Tail-BackShape/RTR24Lien-AvioSys/Board/RJ45hub/production/bom.csv

Designator | Footprint | Quantity | Value | LCSC Part #
_4, _3, _2, |  | 4
J1, J2, J3, J4, J5, J6 | 7810-8P8C | 6 | RJ45
