Tail-BackShape/RTR24Lien-AvioSys/mount/mainIMU.stp

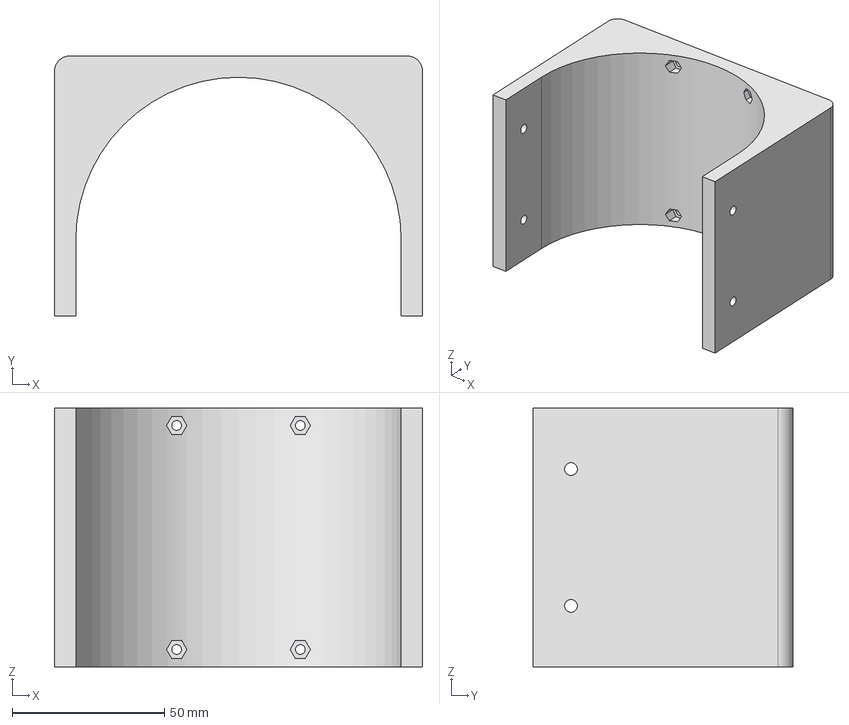
[picture p1: CAD file, 2024-07-04]
mount/mainIMU.stp
121.0 x 85.5 x 85.0 mm
