Tail-BackShape/RTR24Lien-AvioSys/(list of files, cad)

Other CAD files:
mount/OldVersions/airdatasensor.0001.ipt
mount/OldVersions/mainIMU.0003.ipt
mount/airdatasensor.ipt
mount/mainIMU.ipt
mount/mainIMU.stl
