Tail-BackShape/RTR24Lien-AvioSys/Board/AirDataCenter/AirDataCenter.pdf

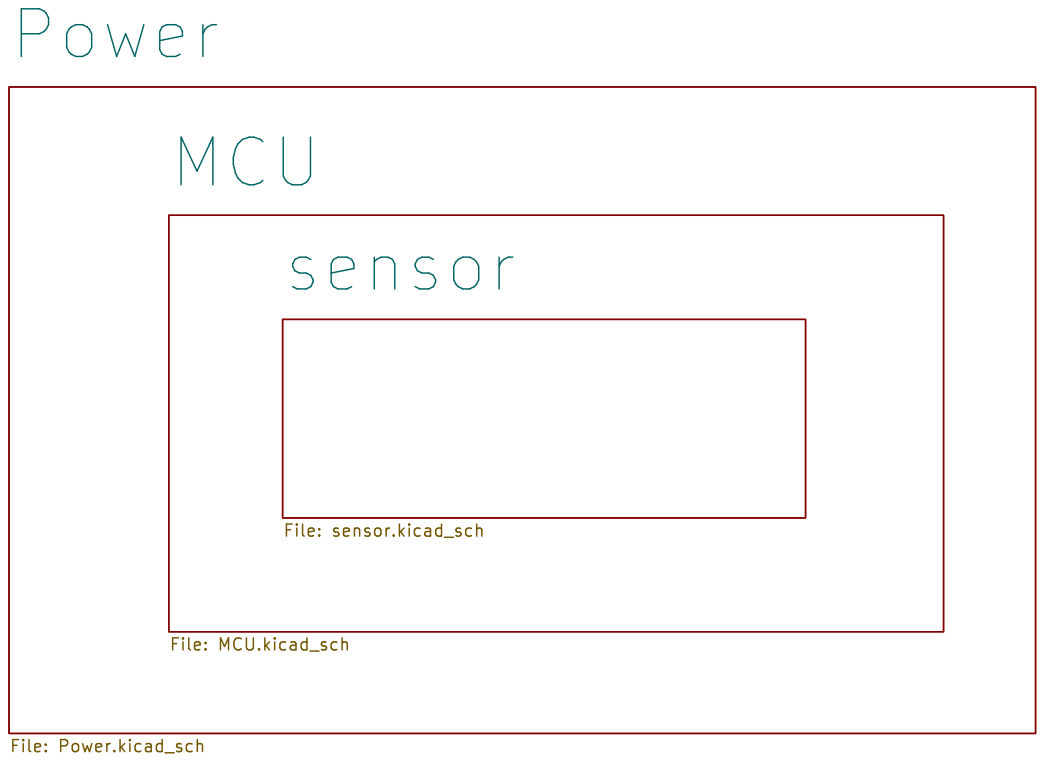
[picture p2: page 1]

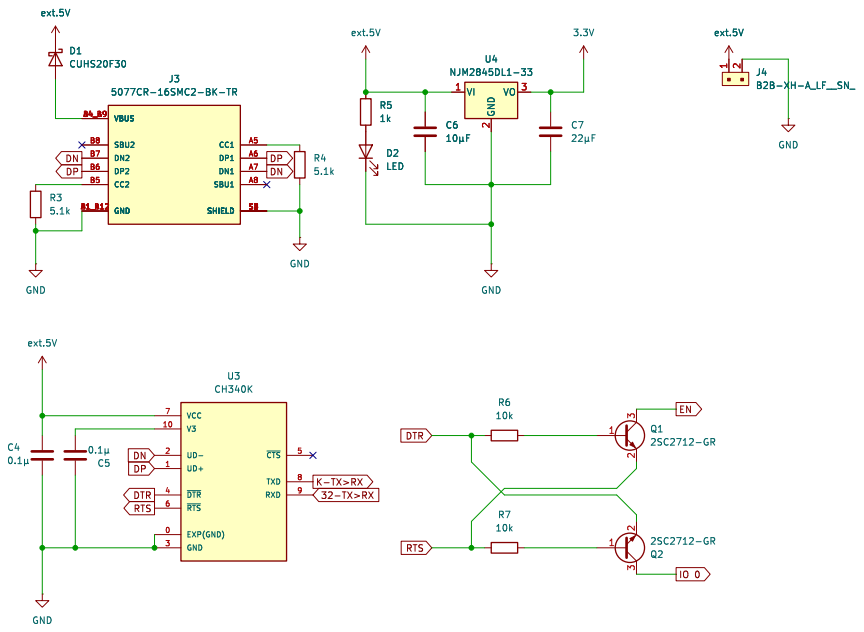
[picture p3: page 2]

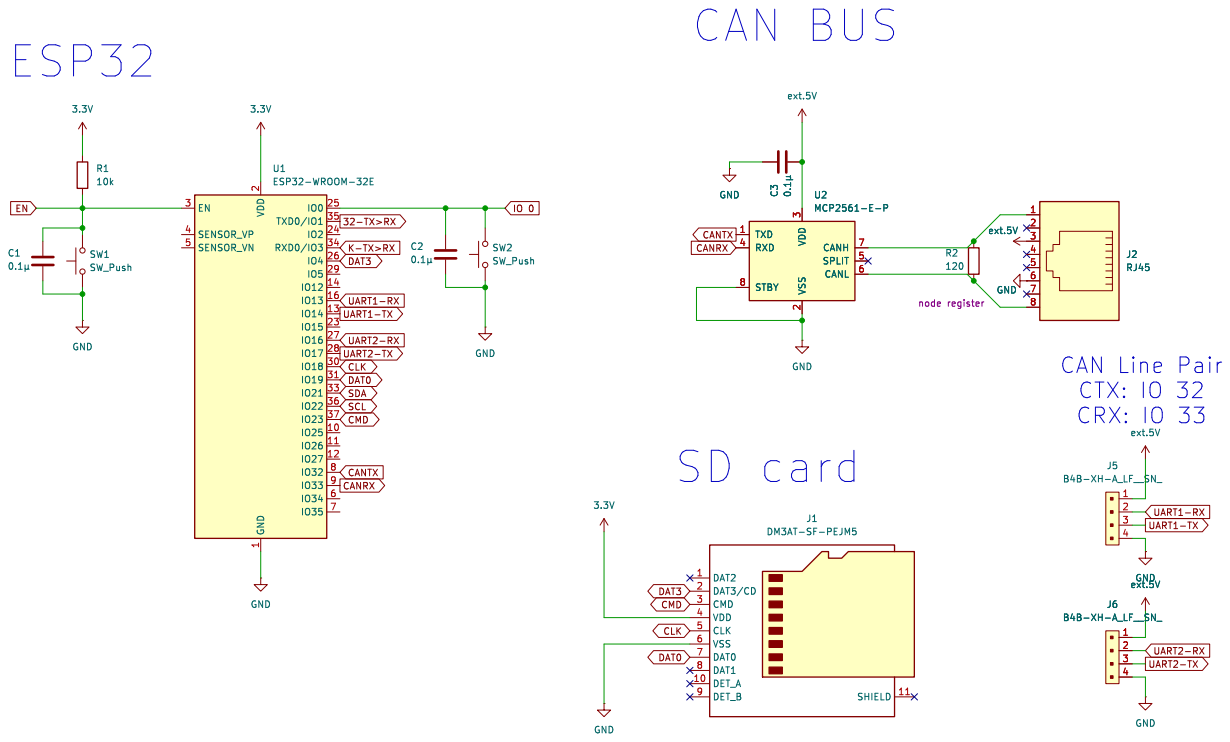
[picture p4: page 3]

node register 3.3V GND GND

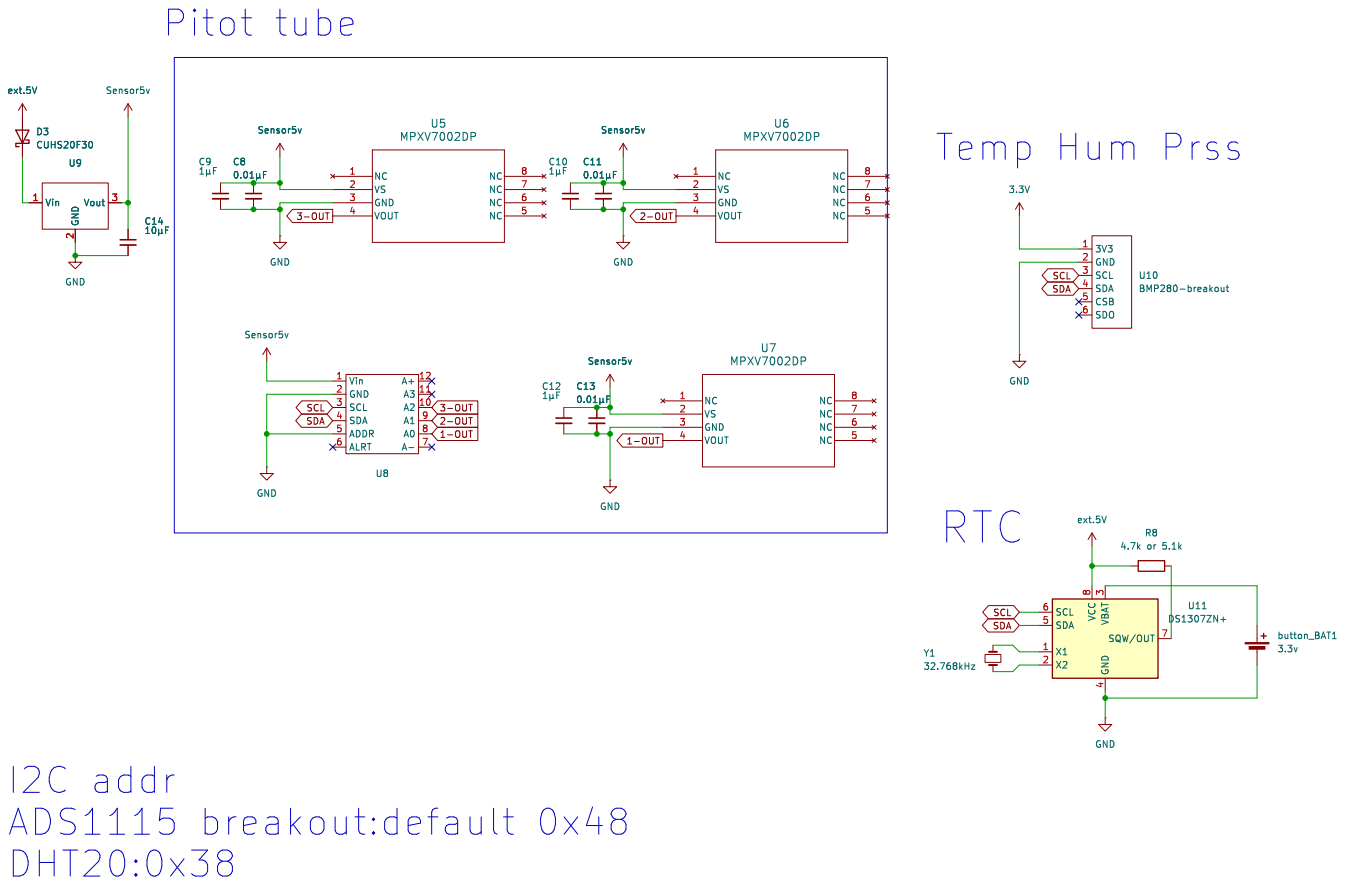
[picture p5: page 4]

8 U11 DS1307ZN+ Vin 1 A2 10 A3 11 A+ 12 GND 2 SCL 3 SDA 4 ADDR 5 ALRT 6 A- 7 A0 8 A1 9 U8 C12

4 SDA 5 SCL 6 SQW/OUT 7 VCC
