Tail-BackShape/RTR24Lien-AvioSys/Board/Main-IMU/Main-IMU.pdf

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

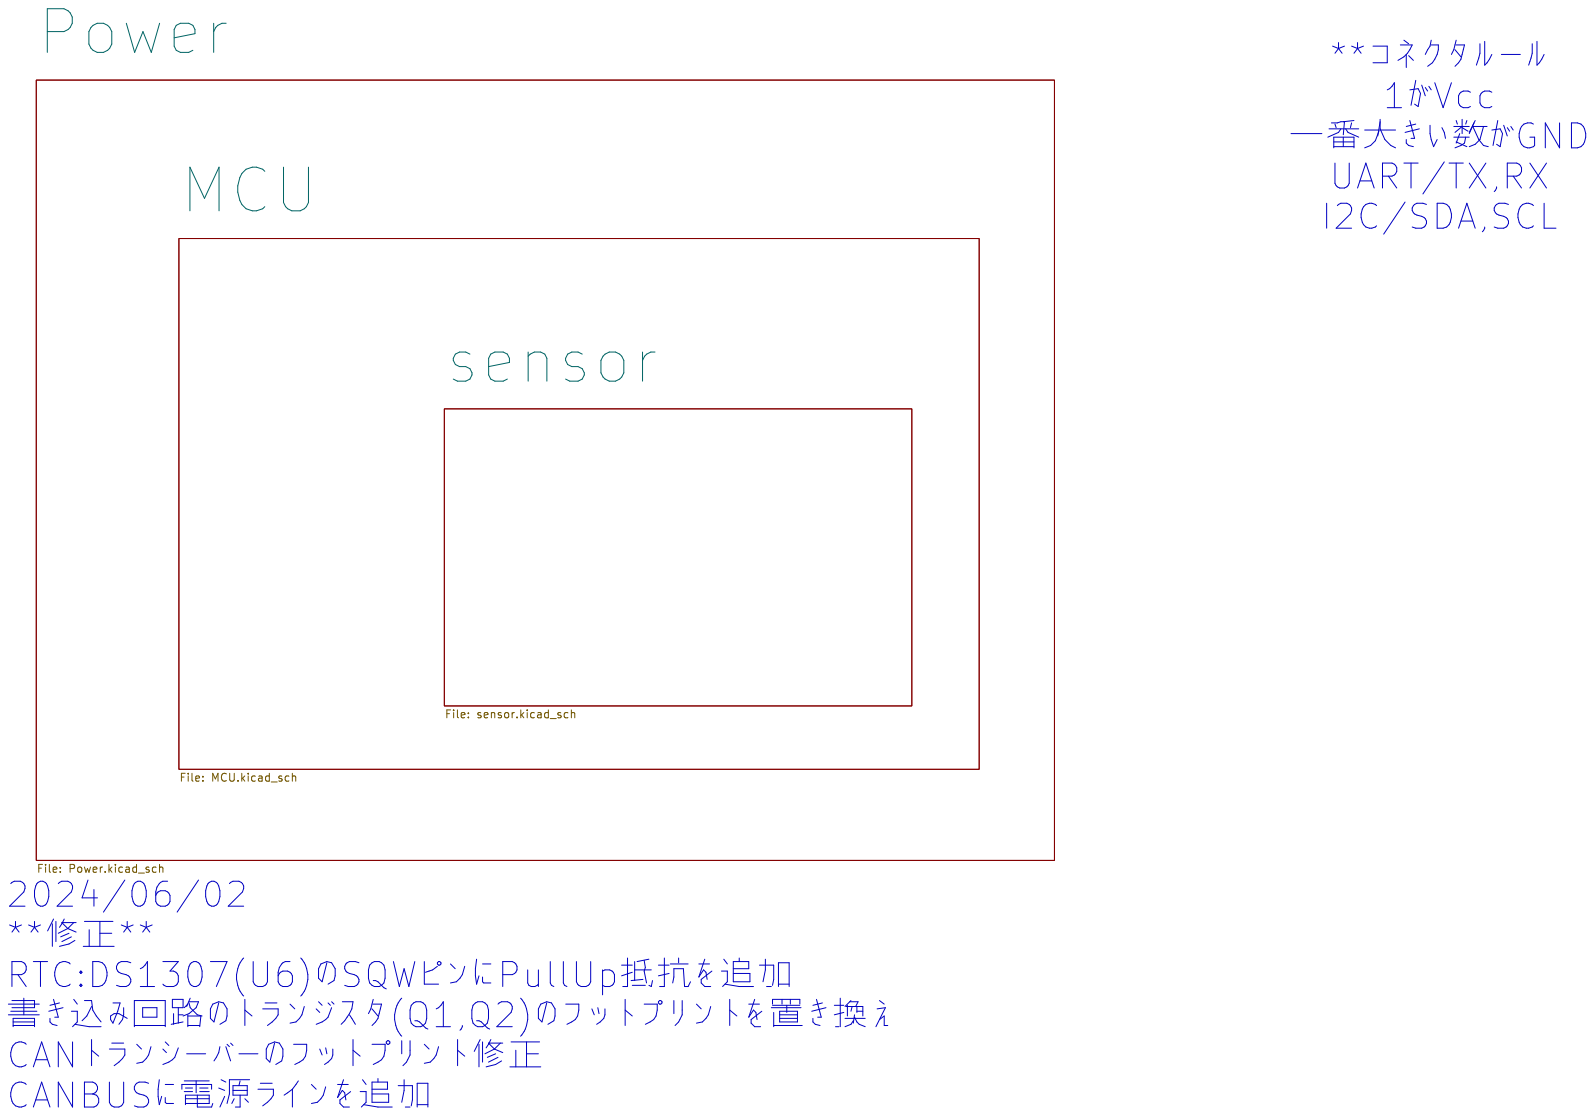
[picture p6: page 1]

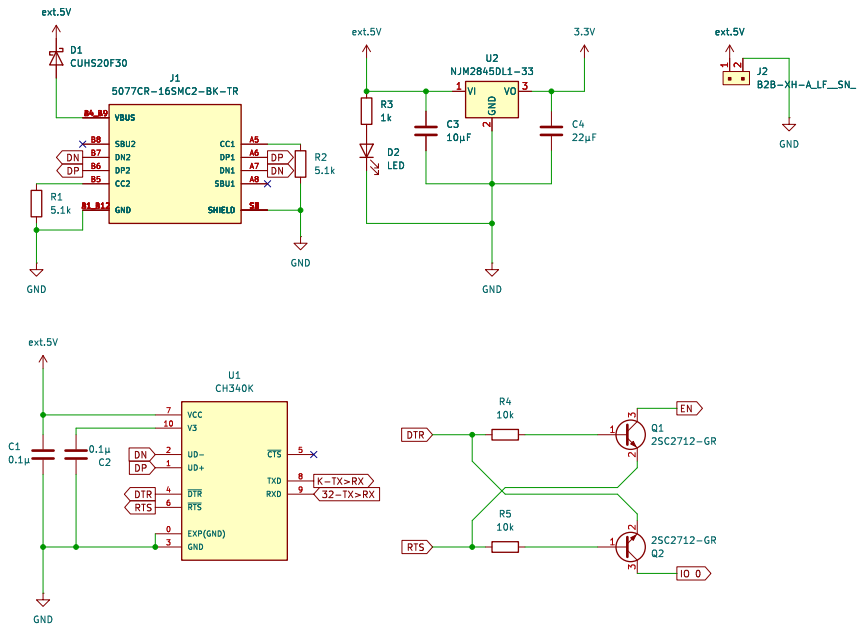
[picture p7: page 2]

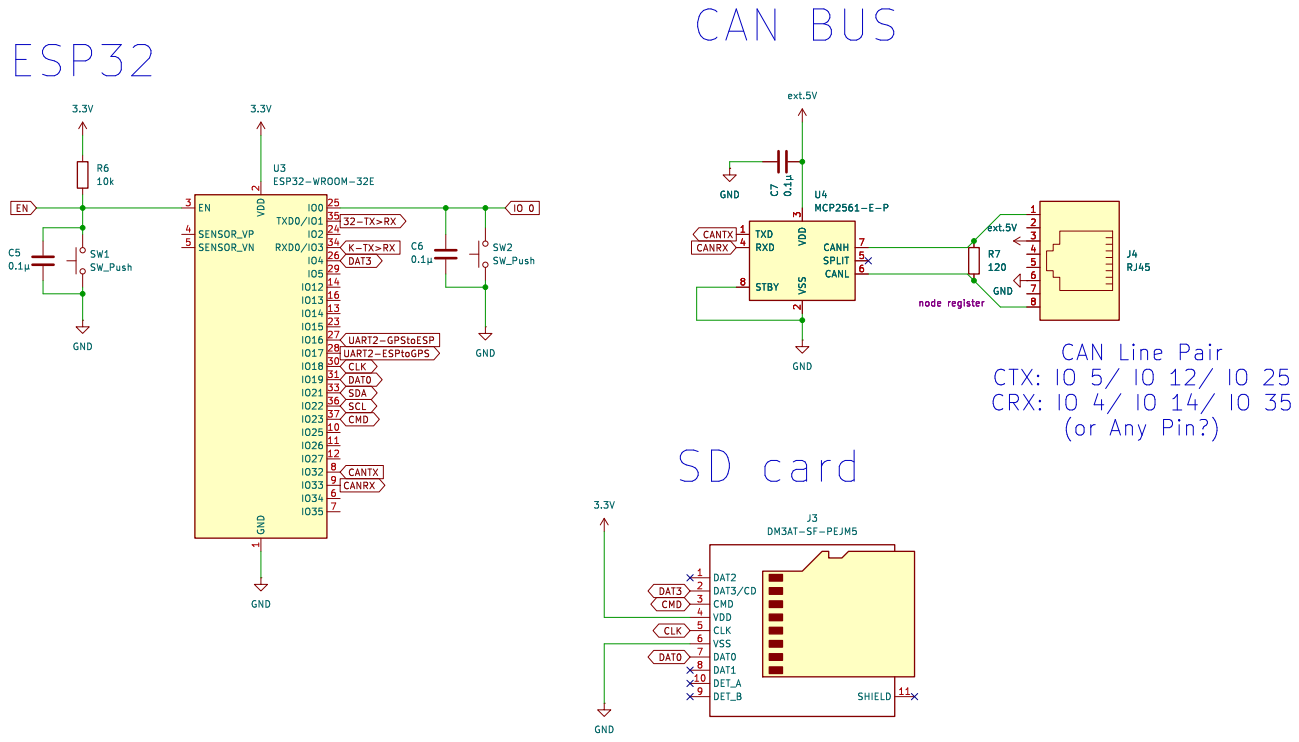
[picture p8: page 3]

CAN Line Pair
CTX: IO 5/ IO 12/ IO 25
CRX: IO 4/ IO 14/ IO 35

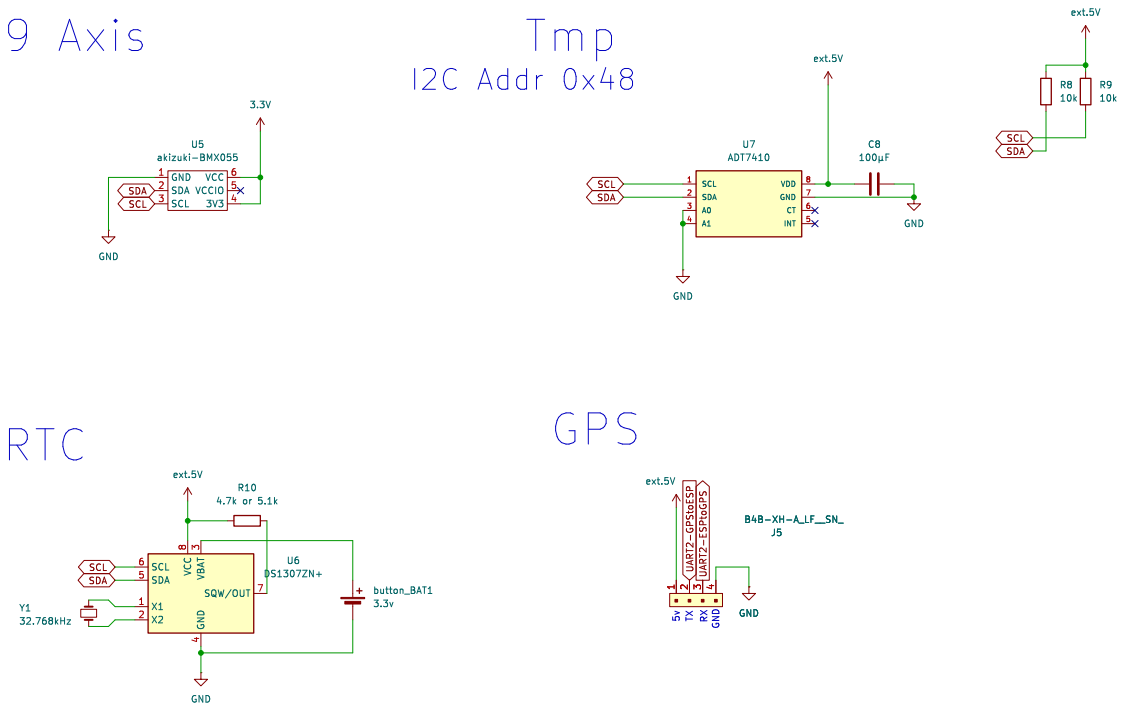
[picture p9: page 4]

4 SDA 5 SCL 6 SQW/OUT 7 VCC
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
