Tail-BackShape/RTR24Lien-AvioSys/Board/RJ45hub/RJ45hub.kicad_pcb

## KiCad design Board/RJ45hub/RJ45hub.kicad_pcb (2024-06-23)

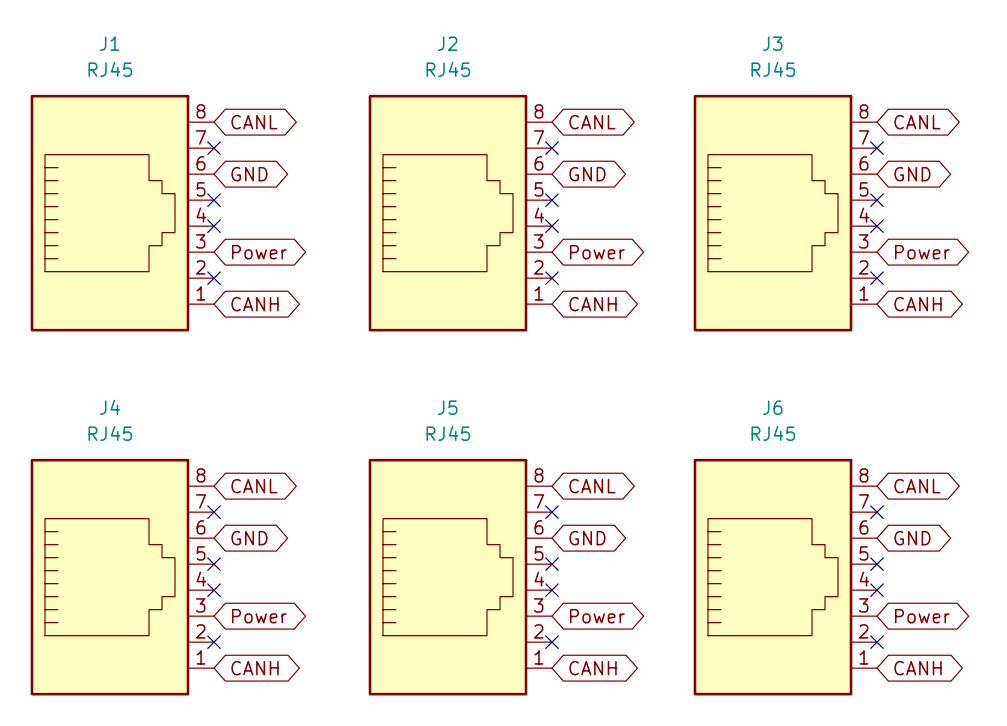
[picture p10: schematic RJ45hub.kicad_sch]

Parts:
J1, J2, J3, J4, J5, J6: RJ45; 7810-8P8C

Connections:
CANH: J1.1, J2.1, J3.1, J4.1, J5.1, J6.1
CANL: J1.8, J2.8, J3.8, J4.8, J5.8, J6.8
GND: J1.6, J2.6, J3.6, J4.6, J5.6, J6.6
Power: J1.3, J2.3, J3.3, J4.3, J5.3, J6.3

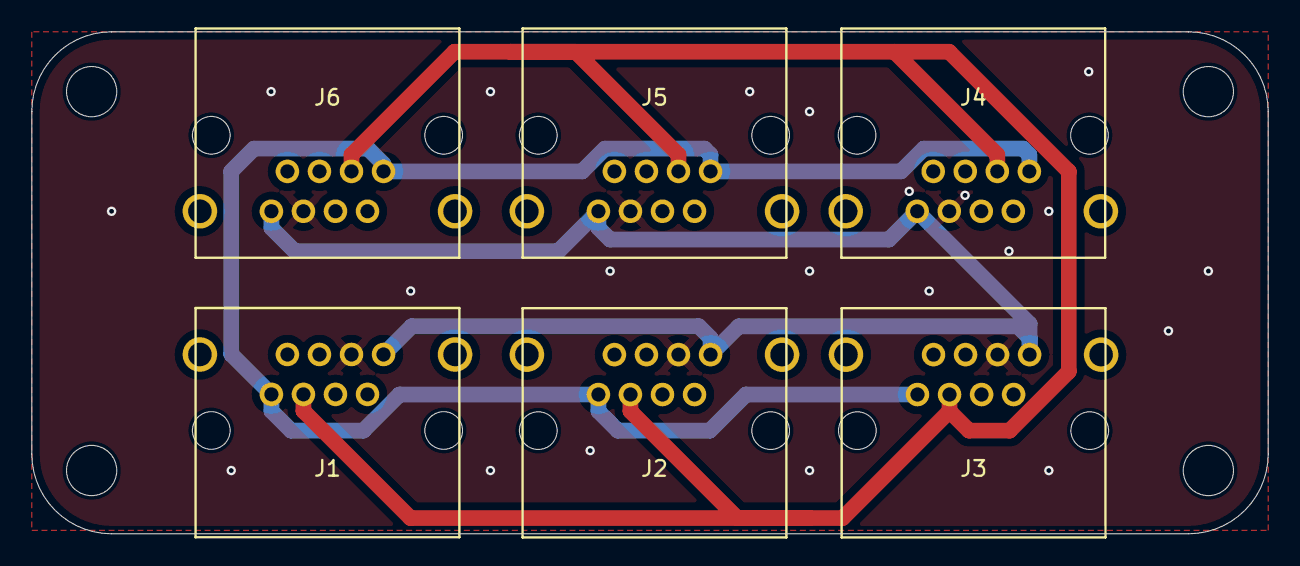
[picture p11: board RJ45hub.kicad_pcb from above]

Board: 2 copper layers, 78.7 x 32.0 mm, 6 parts (0 on the bottom side), 4 nets.
