Tail-BackShape/RTR24Lien-AvioSys/Board/Power/Power.kicad_pcb

## KiCad design Board/Power/Power.kicad_pcb (2024-06-23)

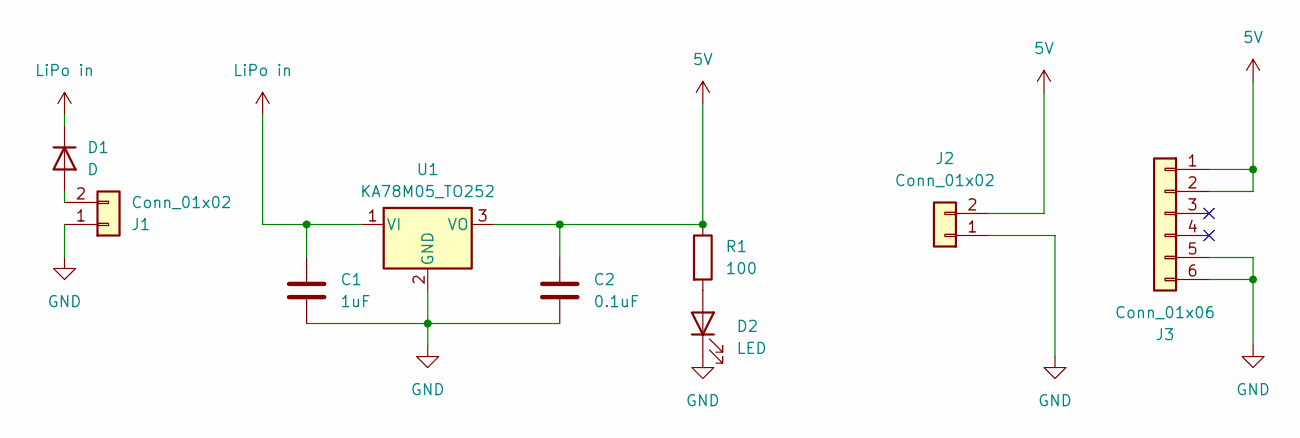
[picture p12: schematic Power.kicad_sch]

Parts:
C1: 1uF; C_0603_1608Metric_Pad1.08x0.95mm_HandSolder; Voltage 1kV; Tolerance 100%
C2: 0.1uF; C_0603_1608Metric_Pad1.08x0.95mm_HandSolder; Voltage 1kV; Tolerance 100%
D1: D; D_SOD-323F
D2: LED; D_0603_1608Metric_Pad1.05x0.95mm_HandSolder
J1: Conn_01x02; AMASS_XT60-F_1x02_P7.20mm_Vertical
J2: Conn_01x02; JST_XH_S2B-XH-A_1x02_P2.50mm_Horizontal
J3: Conn_01x06; JST_GH_SM06B-GHS-TB_1x06-1MP_P1.25mm_Horizontal
R1: 100; R_0603_1608Metric_Pad0.98x0.95mm_HandSolder
U1: KA78M05_TO252; TO-252-2

Connections:
5V: C2.1, J2.2, J3.1, J3.2, R1.1, U1.3 (VO)
GND: C1.2, C2.2, D2.1 (K), J1.1, J2.1, J3.5, J3.6, U1.2 (GND)
LiPo in: C1.1, D1.1 (K), U1.1 (VI)
unnamed: D1.2 (A), J1.2
unnamed: D2.2 (A), R1.2

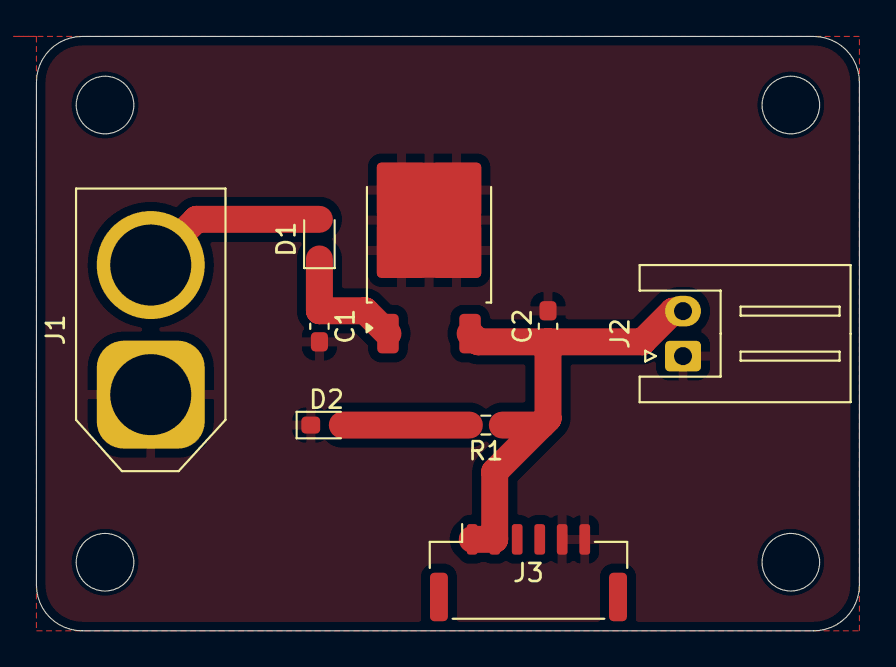
[picture p13: board Power.kicad_pcb from above]

Board: 2 copper layers, 45.7 x 33.0 mm, 9 parts (0 on the bottom side), 5 nets.
