Tail-BackShape/RTR24Lien-AvioSys/Board/Main-IMU/Main-IMU.kicad_pcb

## KiCad design Board/Main-IMU/Main-IMU.kicad_pcb (2024-06-23)

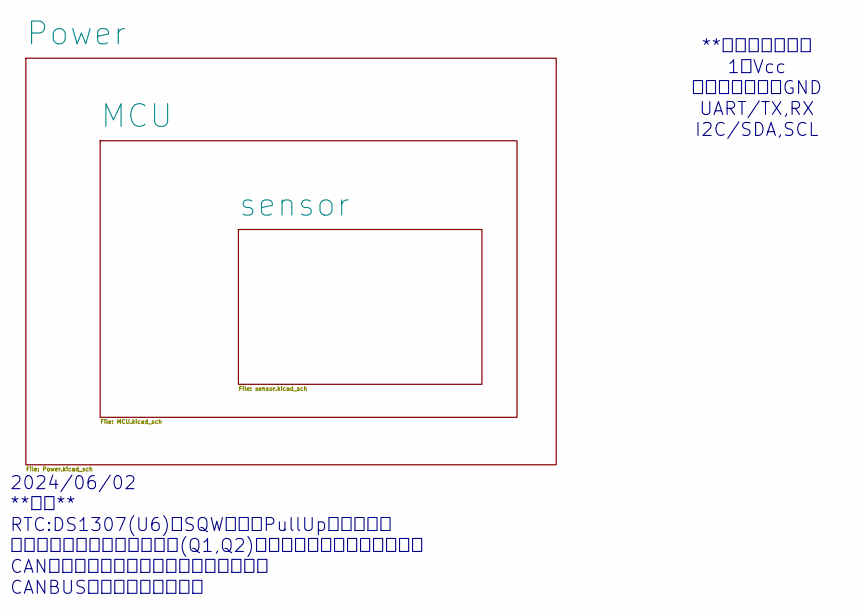
[picture p14: schematic Main-IMU.kicad_sch]

Notes on the sheet:
**コネクタルール 1がVcc 一番大きい数がGND UART/TX,RX I2C/SDA,SCL
2024/06/02 **修正** RTC:DS1307(U6)のSQWピンにPullUp抵抗を追加 書き込み回路のトランジスタ(Q1,Q2)のフットプリントを置き換え CANトランシーバーのフットプリント修正 CANBUSに電源ラインを追加

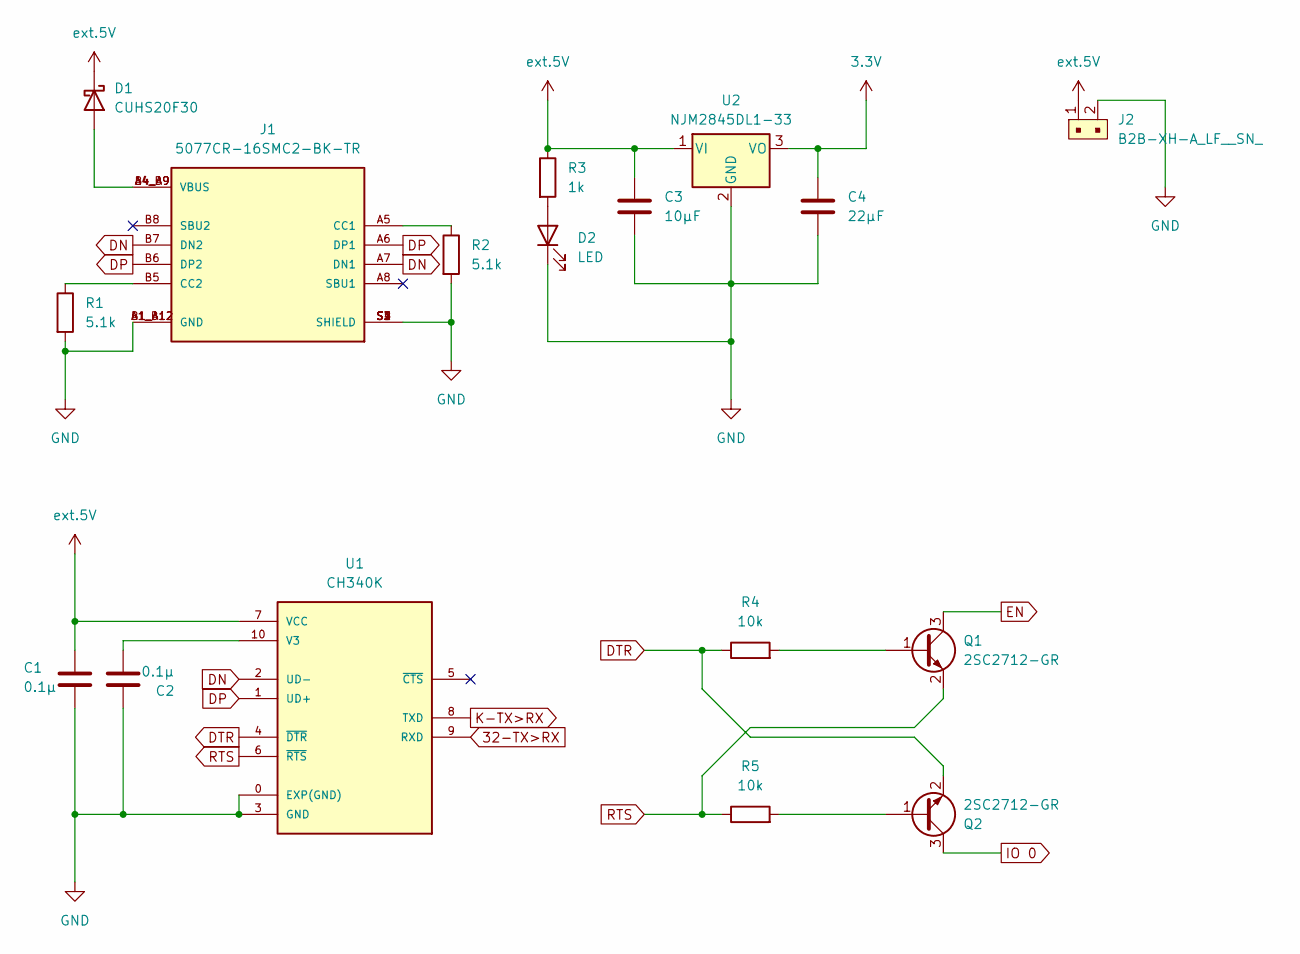
[picture p15: schematic Power.kicad_sch]

Parts:
C1, C2: 0.1μ; C_0603_1608Metric; Voltage 1kV; Tolerance 100%
C3: 10μF; C_0603_1608Metric; Voltage 1kV; Tolerance 100%
C4: 22μF; C_0603_1608Metric; Voltage 1kV; Tolerance 100%
D1: CUHS20F30; D_SOD-323F
D2: LED; LED_0603_1608Metric_Pad1.05x0.95mm_HandSolder
J1: 5077CR-16SMC2-BK-TR; NELTRON_5077CR-16SMC2-BK-TR; PARTREV B
J2: B2B-XH-A_LF__SN_; JST_XH_S2B-XH-A_1x02_P2.50mm_Horizontal; MPN B2B-XH-A(LF)(SN); Digi-Key_PN 455-2247-ND
Q1, Q2: 2SC2712-GR; SC-59_Handsoldering
R1, R2: 5.1k; R_0603_1608Metric_Pad0.98x0.95mm_HandSolder
R3: 1k; R_0603_1608Metric_Pad0.98x0.95mm_HandSolder
R4, R5: 10k; R_0603_1608Metric_Pad0.98x0.95mm_HandSolder
U1: CH340K; ESSOP-10_CH224K; PARTREV 3B
U2: NJM2845DL1-33; TO-252-2

Connections:
3.3V: C4.1, U2.3 (VO); also elsewhere on the board
32-TX>RX: U1.9 (RXD); also elsewhere on the board
DN: J1.A7 (DN1), J1.B7 (DN2), U1.2 (UD-)
DP: J1.A6 (DP1), J1.B6 (DP2), U1.1 (UD+)
DTR: Q2.2 (E), R4.1, U1.4 (~DTR)
EN: Q1.3 (C); also elsewhere on the board
GND: C1.1, C2.2, C3.2, C4.2, D2.1 (K), J1.A1_B12 (GND), J1.B1_A12 (GND), J1.S1 (SHIELD), J1.S2 (SHIELD), J1.S3 (SHIELD), J1.S4 (SHIELD), J2.2, R1.2, R2.2, U1.0 (EXP(GND)), U1.3 (GND), U2.2 (GND); also elsewhere on the board
IO 0: Q2.3 (C); also elsewhere on the board
K-TX>RX: U1.8 (TXD); also elsewhere on the board
unnamed: D1.2 (A), J1.A4_B9 (VBUS), J1.B4_A9 (VBUS)
unnamed: D2.2 (A), R3.2
unnamed: J1.A5 (CC1), R2.1
unnamed: J1.B5 (CC2), R1.1
unnamed: Q1.1 (B), R4.2
unnamed: Q2.1 (B), R5.2
unnamed: C2.1, U1.10 (V3)
RTS: Q1.2 (E), R5.1, U1.6 (~RTS)
ext.5V: C1.2, C3.1, D1.1 (K), J2.1, R3.1, U1.7 (VCC), U2.1 (VI); also elsewhere on the board

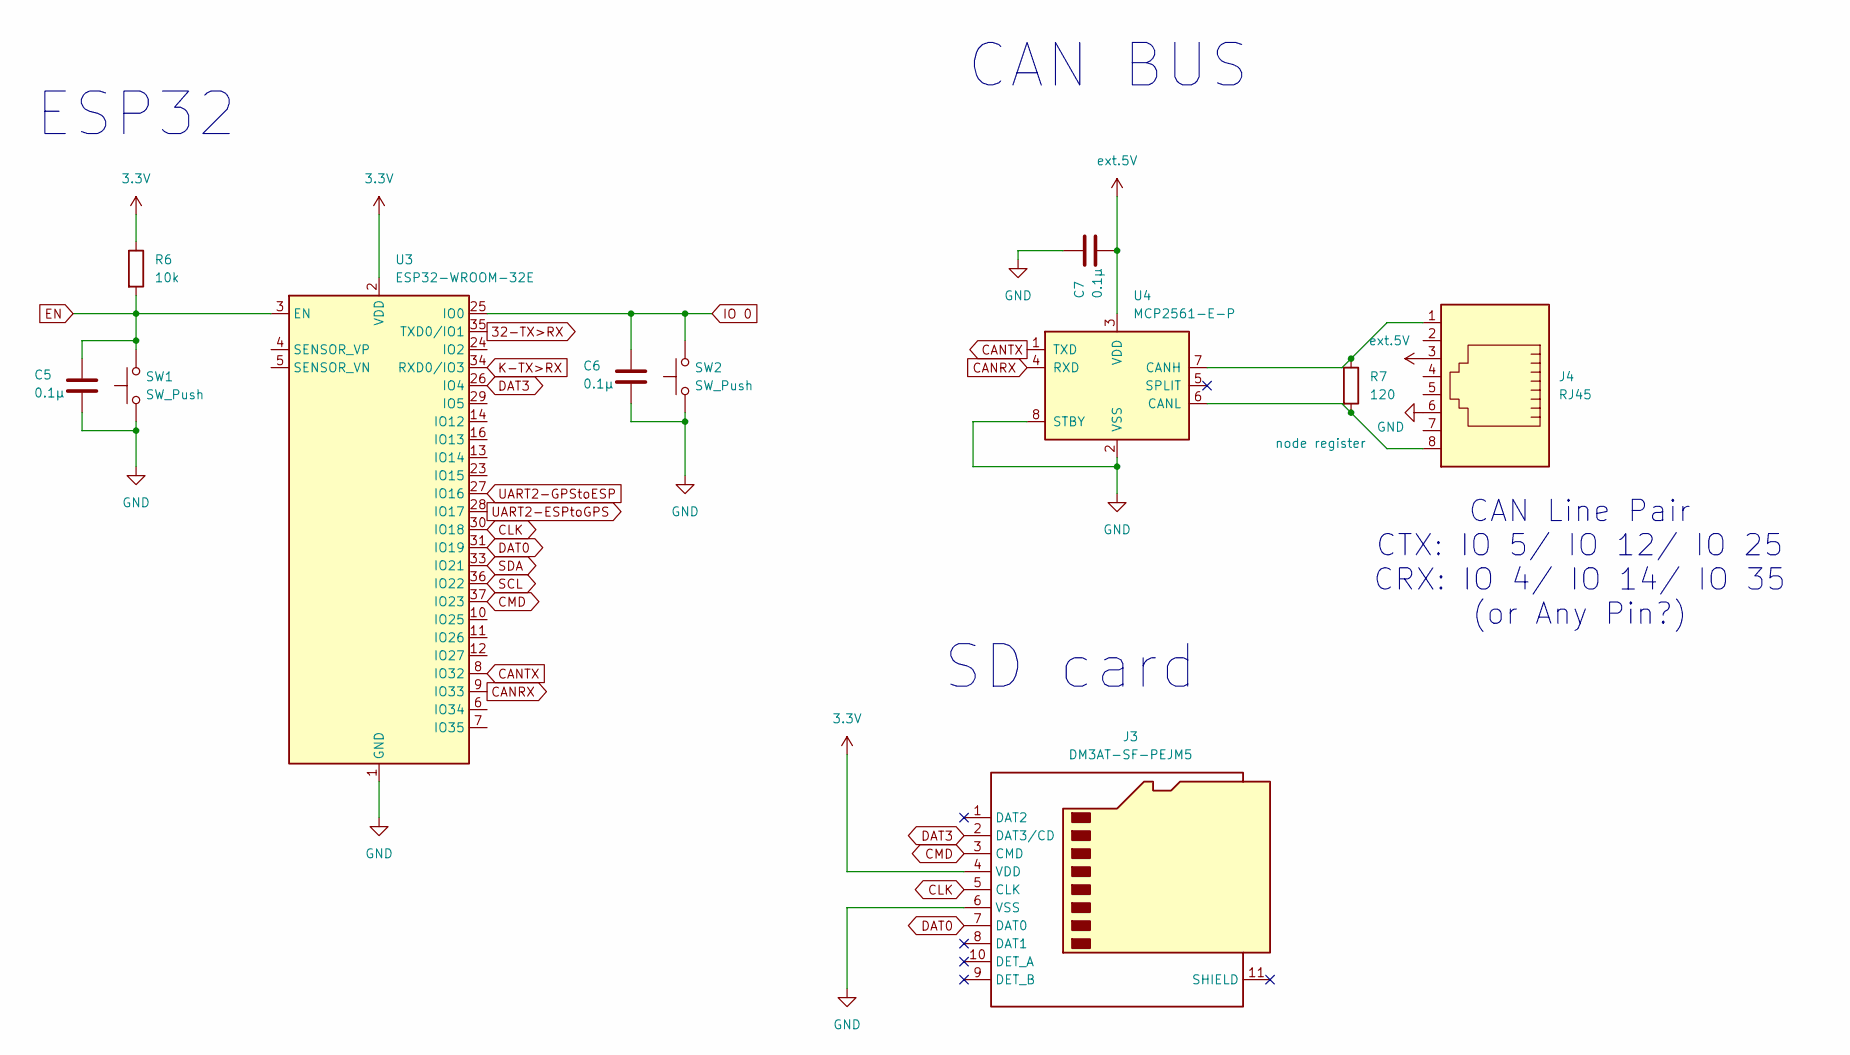
[picture p16: schematic MCU.kicad_sch]

Parts:
C5, C6, C7: 0.1μ; C_0603_1608Metric; Voltage 1kV; Tolerance 100%
J3: DM3AT-SF-PEJM5; microSD_HC_Hirose_DM3AT-SF-PEJM5
J4: RJ45; 7810-8P8C
R6: 10k; R_0603_1608Metric_Pad0.98x0.95mm_HandSolder
R7: 120; R_0603_1608Metric_Pad0.98x0.95mm_HandSolder
SW1, SW2: SW_Push; TVAF06-A020B-R
U3: ESP32-WROOM-32E
U4: MCP2561-E-P; DIP-8_W7.62mm_LongPads

Connections:
3.3V: J3.4 (VDD), R6.1, U3.2 (VDD); also elsewhere on the board
32-TX>RX: U3.35 (TXD0/IO1); also elsewhere on the board
CANRX: U3.9 (IO33), U4.4 (RXD)
CANTX: U3.8 (IO32), U4.1 (TXD)
CLK: J3.5 (CLK), U3.30 (IO18)
CMD: J3.3 (CMD), U3.37 (IO23)
DAT0: J3.7 (DAT0), U3.31 (IO19)
DAT3: J3.2 (DAT3/CD), U3.26 (IO4)
EN: C5.2, R6.2, SW1.2, U3.3 (EN); also elsewhere on the board
GND: C5.1, C6.1, C7.2, J3.6 (VSS), J4.6, SW1.1, SW2.1, U3.1 (GND), U3.15 (GND), U3.38 (GND), U3.39 (GND), U4.2 (VSS), U4.8 (STBY); also elsewhere on the board
IO 0: C6.2, SW2.2, U3.25 (IO0); also elsewhere on the board
K-TX>RX: U3.34 (RXD0/IO3); also elsewhere on the board
unnamed: J4.1, R7.1, U4.7 (CANH)
unnamed: J4.8, R7.2, U4.6 (CANL)
SCL: U3.36 (IO22); also elsewhere on the board
SDA: U3.33 (IO21); also elsewhere on the board
UART2-ESPtoGPS: U3.28 (IO17); also elsewhere on the board
UART2-GPStoESP: U3.27 (IO16); also elsewhere on the board
ext.5V: C7.1, J4.3, U4.3 (VDD); also elsewhere on the board

Notes on the sheet:
ESP32
CAN BUS
SD card
CAN Line Pair CTX: IO 5/ IO 12/ IO 25 CRX: IO 4/ IO 14/ IO 35 (or Any Pin?)

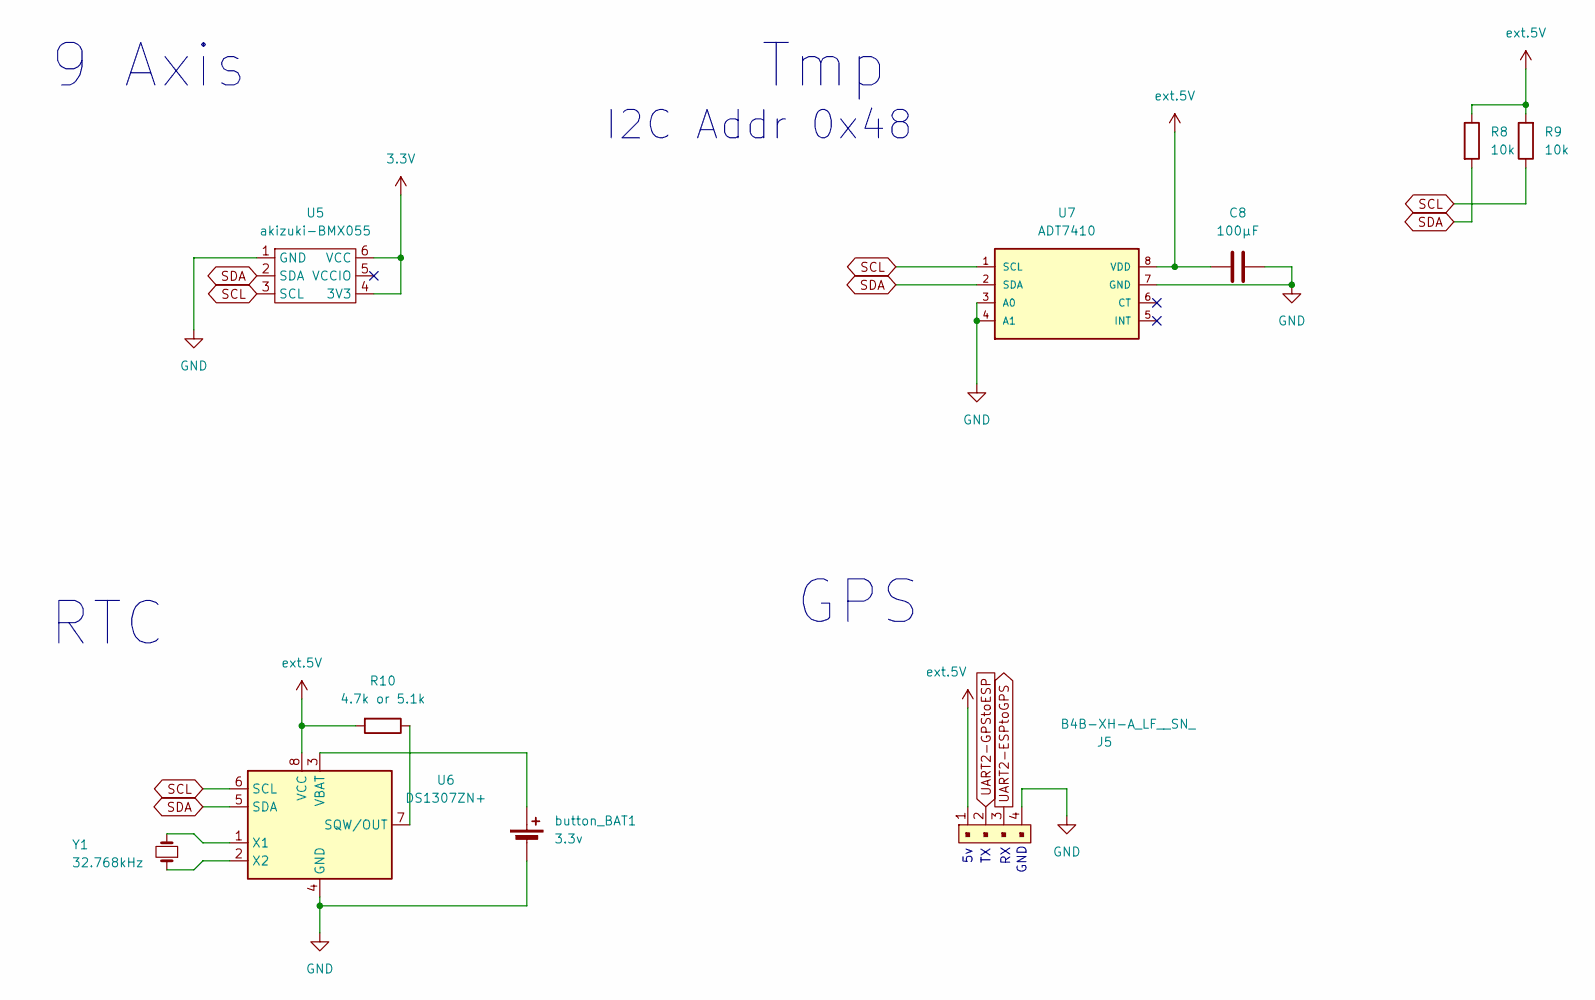
[picture p17: schematic sensor.kicad_sch]

Parts:
C8: 100μF; C_0603_1608Metric; Voltage 1kV; Tolerance 100%
J5: B4B-XH-A_LF__SN_; JST_XH_S4B-XH-A-1_1x04_P2.50mm_Horizontal; MPN B4B-XH-A(LF)(SN); Digi-Key_PN 455-2249-ND
R8, R9: 10k; R_0603_1608Metric_Pad0.98x0.95mm_HandSolder
R10: 4.7k or 5.1k; R_0603_1608Metric_Pad0.98x0.95mm_HandSolder
U5: akizuki-BMX055; DIP-6_W7.62mm
U6: DS1307ZN+; SOIC-8_3.9x4.9mm_P1.27mm
U7: ADT7410; SOIC-8_3.9x4.9mm_P1.27mm
Y1: 32.768kHz; Crystal_SMD_5032-2Pin_5.0x3.2mm
button_BAT1: 3.3v; BAT_CH291-1220LF

Connections:
3.3V: U5.4 (3V3), U5.6 (VCC); also elsewhere on the board
GND: C8.2, J5.4, U5.1 (GND), U6.4 (GND), U7.3 (A0), U7.4 (A1), U7.7 (GND), button_BAT1.2 (-); also elsewhere on the board
unnamed: R10.1, U6.7 (SQW/OUT)
unnamed: U6.3 (VBAT), button_BAT1.1 (+)
unnamed: U6.1 (X1), Y1.2
unnamed: U6.2 (X2), Y1.1
SCL: R9.1, U5.3 (SCL), U6.6 (SCL), U7.1 (SCL); also elsewhere on the board
SDA: R8.2, U5.2 (SDA), U6.5 (SDA), U7.2 (SDA); also elsewhere on the board
UART2-ESPtoGPS: J5.3; also elsewhere on the board
UART2-GPStoESP: J5.2; also elsewhere on the board
ext.5V: C8.1, J5.1, R8.1, R9.2, R10.2, U6.8 (VCC), U7.8 (VDD); also elsewhere on the board

Notes on the sheet:
9 Axis
Tmp
GPS
GND
RTC
I2C Addr 0x48

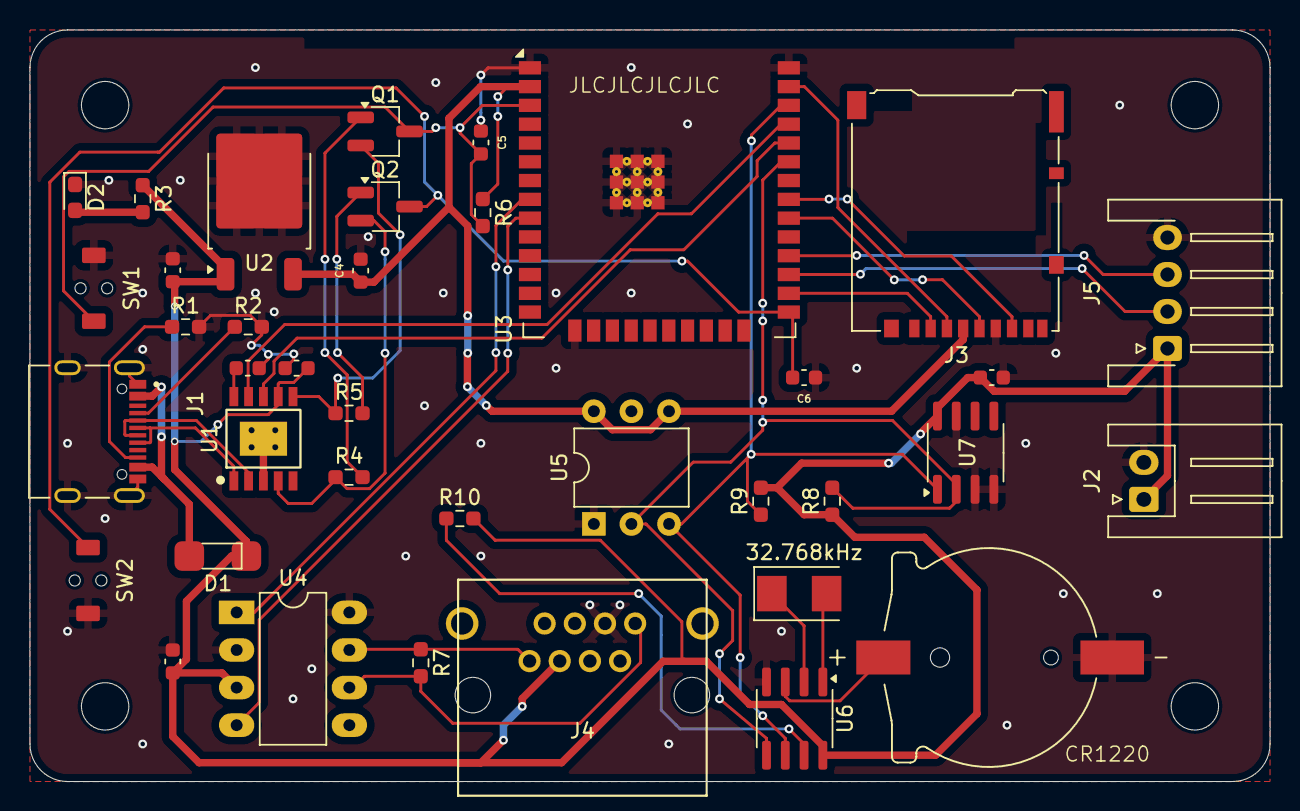
[picture p18: board Main-IMU.kicad_pcb from above]

Board: 2 copper layers, 83.8 x 50.8 mm, 38 parts (0 on the bottom side), 34 nets.
