Tail-BackShape/RTR24Lien-AvioSys/Board/AirDataCenter/AirDataCenter.kicad_pcb

## KiCad design Board/AirDataCenter/AirDataCenter.kicad_pcb (2024-06-23)

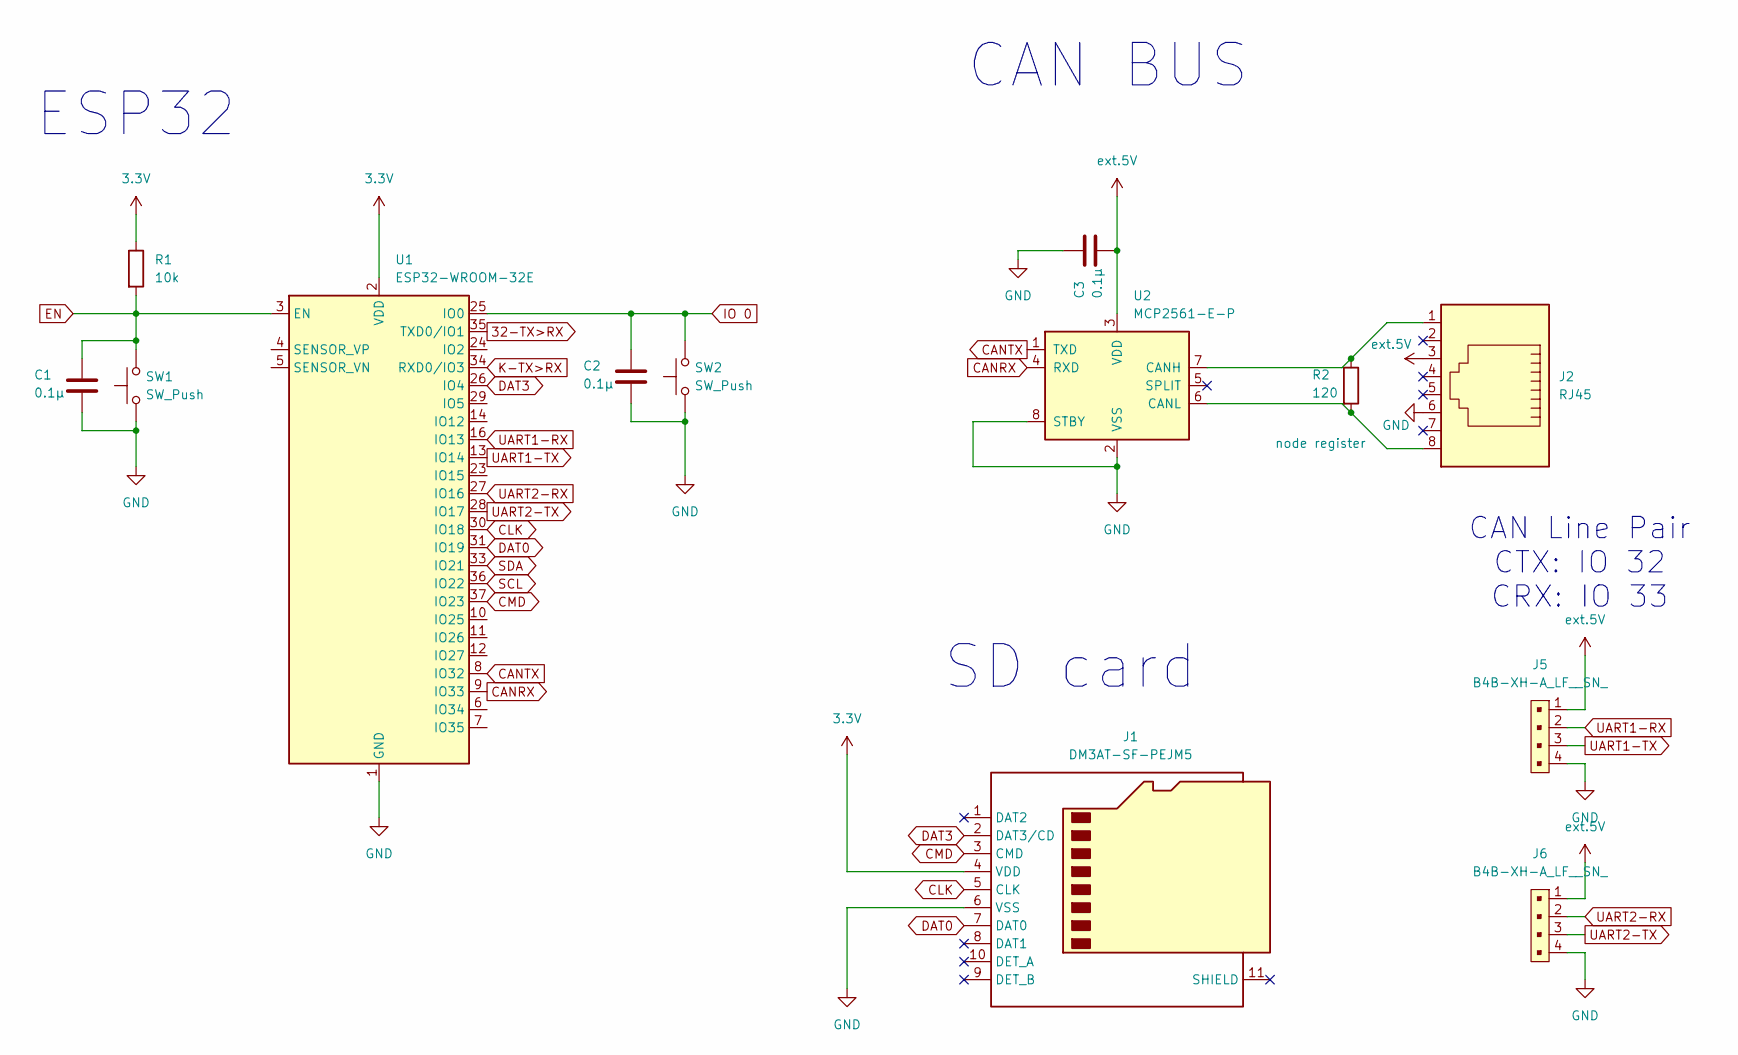
[picture p19: schematic MCU.kicad_sch]

Parts:
C1, C2, C3: 0.1μ; C_0603_1608Metric_Pad1.08x0.95mm_HandSolder; Voltage 1kV; Tolerance 100%
J1: DM3AT-SF-PEJM5; microSD_HC_Hirose_DM3AT-SF-PEJM5
J2: RJ45; 7810-8P8C
J5, J6: B4B-XH-A_LF__SN_; JST_XH_S4B-XH-A_1x04_P2.50mm_Horizontal; MPN B4B-XH-A(LF)(SN); Digi-Key_PN 455-2249-ND
R1: 10k; R_0603_1608Metric_Pad0.98x0.95mm_HandSolder
R2: 120; R_0603_1608Metric_Pad0.98x0.95mm_HandSolder
SW1, SW2: SW_Push; TVAF06-A020B-R
U1: ESP32-WROOM-32E
U2: MCP2561-E-P; DIP-8_W10.16mm_LongPads

Connections:
3.3V: J1.4 (VDD), R1.1, U1.2 (VDD); also elsewhere on the board
32-TX>RX: U1.35 (TXD0/IO1); also elsewhere on the board
CANRX: U1.9 (IO33), U2.4 (RXD)
CANTX: U1.8 (IO32), U2.1 (TXD)
CLK: J1.5 (CLK), U1.30 (IO18)
CMD: J1.3 (CMD), U1.37 (IO23)
DAT0: J1.7 (DAT0), U1.31 (IO19)
DAT3: J1.2 (DAT3/CD), U1.26 (IO4)
EN: C1.2, R1.2, SW1.2, U1.3 (EN); also elsewhere on the board
GND: C1.1, C2.1, C3.2, J1.6 (VSS), J2.6, J5.4, J6.4, SW1.1, SW2.1, U1.1 (GND), U1.15 (GND), U1.38 (GND), U1.39 (GND), U2.2 (VSS), U2.8 (STBY); also elsewhere on the board
IO 0: C2.2, SW2.2, U1.25 (IO0); also elsewhere on the board
K-TX>RX: U1.34 (RXD0/IO3); also elsewhere on the board
unnamed: J2.1, R2.1, U2.7 (CANH)
unnamed: J2.8, R2.2, U2.6 (CANL)
SCL: U1.36 (IO22); also elsewhere on the board
SDA: U1.33 (IO21); also elsewhere on the board
UART1-RX: J5.2, U1.16 (IO13)
UART1-TX: J5.3, U1.13 (IO14)
UART2-RX: J6.2, U1.27 (IO16)
UART2-TX: J6.3, U1.28 (IO17)
ext.5V: C3.1, J2.3, J5.1, J6.1, U2.3 (VDD); also elsewhere on the board

Notes on the sheet:
ESP32
SD card
CAN Line Pair CTX: IO 32 CRX: IO 33
CAN BUS

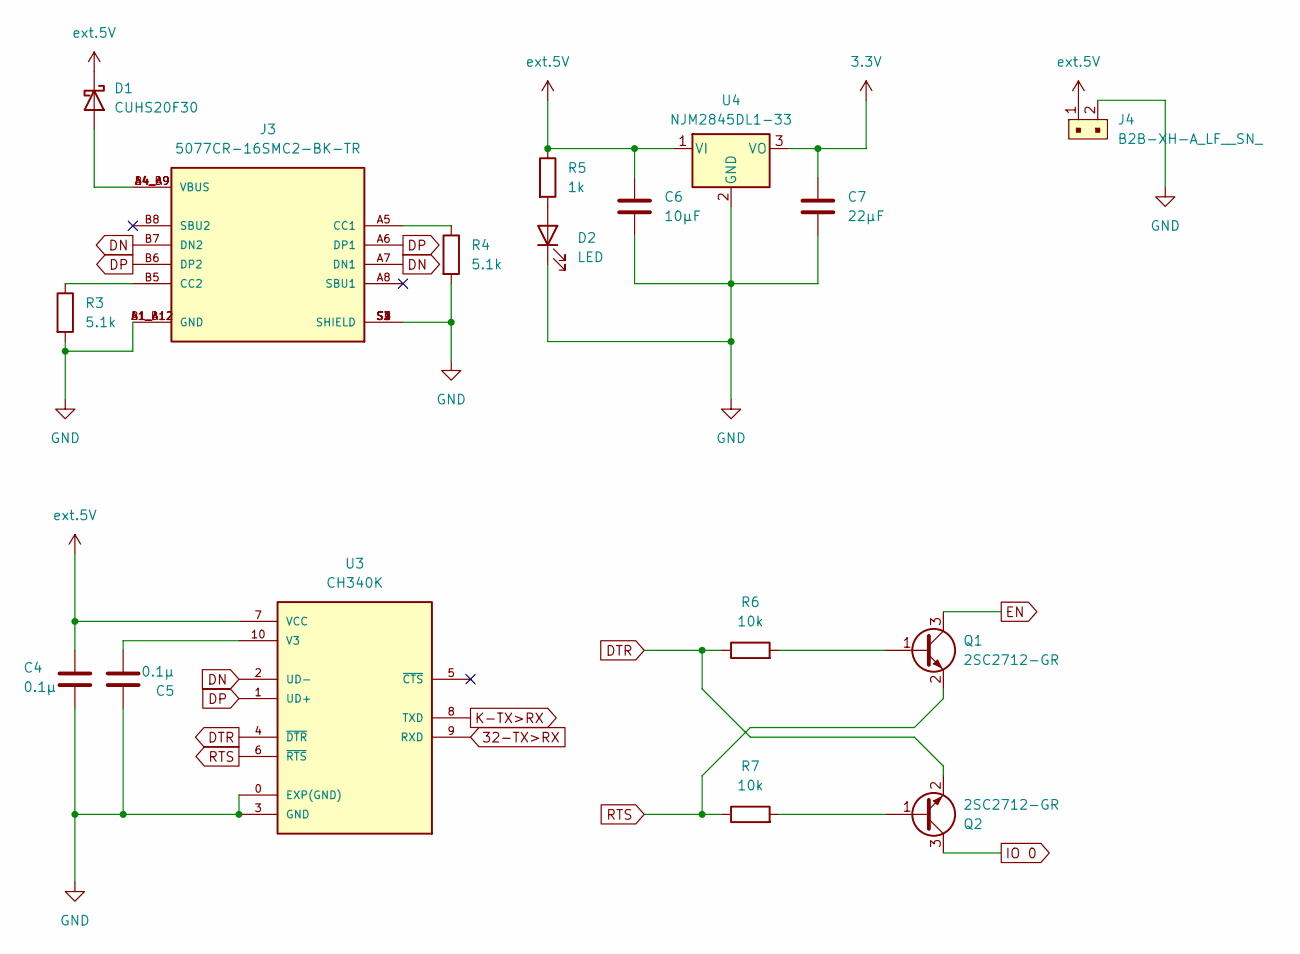
[picture p20: schematic Power.kicad_sch]

Parts:
C4, C5: 0.1μ; C_0603_1608Metric_Pad1.08x0.95mm_HandSolder; Voltage 1kV; Tolerance 100%
C6: 10μF; C_0603_1608Metric_Pad1.08x0.95mm_HandSolder; Voltage 1kV; Tolerance 100%
C7: 22μF; C_0603_1608Metric_Pad1.08x0.95mm_HandSolder; Voltage 1kV; Tolerance 100%
D1: CUHS20F30; D_SOD-323F
D2: LED; LED_0603_1608Metric_Pad1.05x0.95mm_HandSolder
J3: 5077CR-16SMC2-BK-TR; NELTRON_5077CR-16SMC2-BK-TR; PARTREV B
J4: B2B-XH-A_LF__SN_; JST_XH_S2B-XH-A_1x02_P2.50mm_Horizontal; MPN B2B-XH-A(LF)(SN); Digi-Key_PN 455-2247-ND
Q1, Q2: 2SC2712-GR; SC-59_Handsoldering
R3, R4: 5.1k; R_0603_1608Metric_Pad0.98x0.95mm_HandSolder
R5: 1k; R_0603_1608Metric_Pad0.98x0.95mm_HandSolder
R6, R7: 10k; R_0603_1608Metric_Pad0.98x0.95mm_HandSolder
U3: CH340K; ESSOP-10_CH224K; PARTREV 3B
U4: NJM2845DL1-33; TO-252-2

Connections:
3.3V: C7.1, U4.3 (VO); also elsewhere on the board
32-TX>RX: U3.9 (RXD); also elsewhere on the board
DN: J3.A7 (DN1), J3.B7 (DN2), U3.2 (UD-)
DP: J3.A6 (DP1), J3.B6 (DP2), U3.1 (UD+)
DTR: Q2.2 (E), R6.1, U3.4 (~DTR)
EN: Q1.3 (C); also elsewhere on the board
GND: C4.1, C5.2, C6.2, C7.2, D2.1 (K), J3.A1_B12 (GND), J3.B1_A12 (GND), J3.S1 (SHIELD), J3.S2 (SHIELD), J3.S3 (SHIELD), J3.S4 (SHIELD), J4.2, R3.2, R4.2, U3.0 (EXP(GND)), U3.3 (GND), U4.2 (GND); also elsewhere on the board
IO 0: Q2.3 (C); also elsewhere on the board
K-TX>RX: U3.8 (TXD); also elsewhere on the board
unnamed: D1.2 (A), J3.A4_B9 (VBUS), J3.B4_A9 (VBUS)
unnamed: D2.2 (A), R5.2
unnamed: J3.A5 (CC1), R4.1
unnamed: J3.B5 (CC2), R3.1
unnamed: Q1.1 (B), R6.2
unnamed: Q2.1 (B), R7.2
unnamed: C5.1, U3.10 (V3)
RTS: Q1.2 (E), R7.1, U3.6 (~RTS)
ext.5V: C4.2, C6.1, D1.1 (K), J4.1, R5.1, U3.7 (VCC), U4.1 (VI); also elsewhere on the board

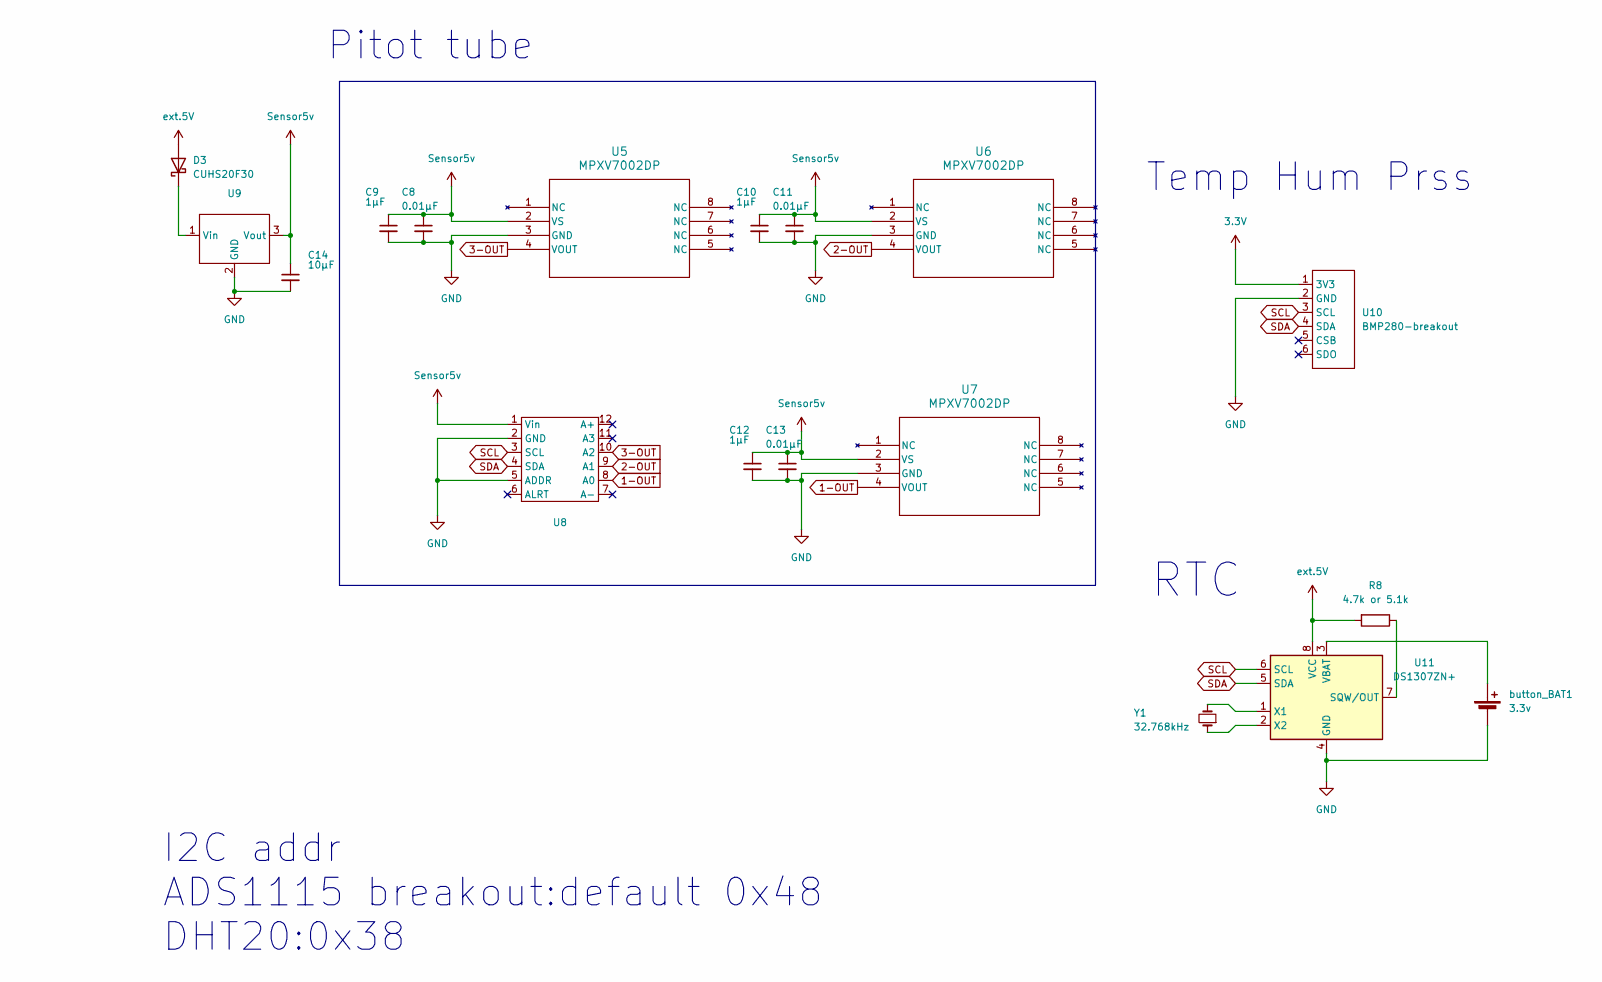
[picture p21: schematic sensor.kicad_sch, part in row 1, column 2]

Parts:
C8, C11, C13: 0.01μF; C_0603_1608Metric_Pad1.08x0.95mm_HandSolder
C9, C10, C12: 1μF; C_0603_1608Metric_Pad1.08x0.95mm_HandSolder
C14: 10μF; C_0603_1608Metric_Pad1.08x0.95mm_HandSolder
D3: CUHS20F30; D_SOD-323F
R8: 4.7k or 5.1k; R_0603_1608Metric_Pad0.98x0.95mm_HandSolder
U5, U6, U7: MPXV7002DP
U8: ADS1115
U9: DCDC-5V
U10: BMP280-breakout
U11: DS1307ZN+; SOIC-8_3.9x4.9mm_P1.27mm
Y1: 32.768kHz; Crystal_SMD_5032-2Pin_5.0x3.2mm
button_BAT1: 3.3v; BAT_CH291-1220LF

Connections:
1-OUT: U7.4 (VOUT), U8.8 (A0)
2-OUT: U6.4 (VOUT), U8.9 (A1)
3-OUT: U5.4 (VOUT), U8.10 (A2)
3.3V: U10.1 (3V3); also elsewhere on the board
GND: C8.2, C9.2, C10.2, C11.2, C12.2, C13.2, C14.2, U5.3 (GND), U6.3 (GND), U7.3 (GND), U8.2 (GND), U8.5 (ADDR), U9.2 (GND), U10.2 (GND), U11.4 (GND), button_BAT1.2 (-); also elsewhere on the board
unnamed: D3.1 (K), U9.1 (Vin)
unnamed: R8.1, U11.7 (SQW/OUT)
unnamed: U11.3 (VBAT), button_BAT1.1 (+)
unnamed: U11.1 (X1), Y1.2
unnamed: U11.2 (X2), Y1.1
SCL: U8.3 (SCL), U10.3 (SCL), U11.6 (SCL); also elsewhere on the board
SDA: U8.4 (SDA), U10.4 (SDA), U11.5 (SDA); also elsewhere on the board
Sensor5v: C8.1, C9.1, C10.1, C11.1, C12.1, C13.1, C14.1, U5.2 (VS), U6.2 (VS), U7.2 (VS), U8.1 (Vin), U9.3 (Vout)
ext.5V: D3.2 (A), R8.2, U11.8 (VCC); also elsewhere on the board

Notes on the sheet:
RTC
https://electronicwork.shop/items/6228175c9a70620780029691
Temp Hum Prss
Pitot tube
I2C addr ADS1115 breakout:default 0x48 DHT20:0x38

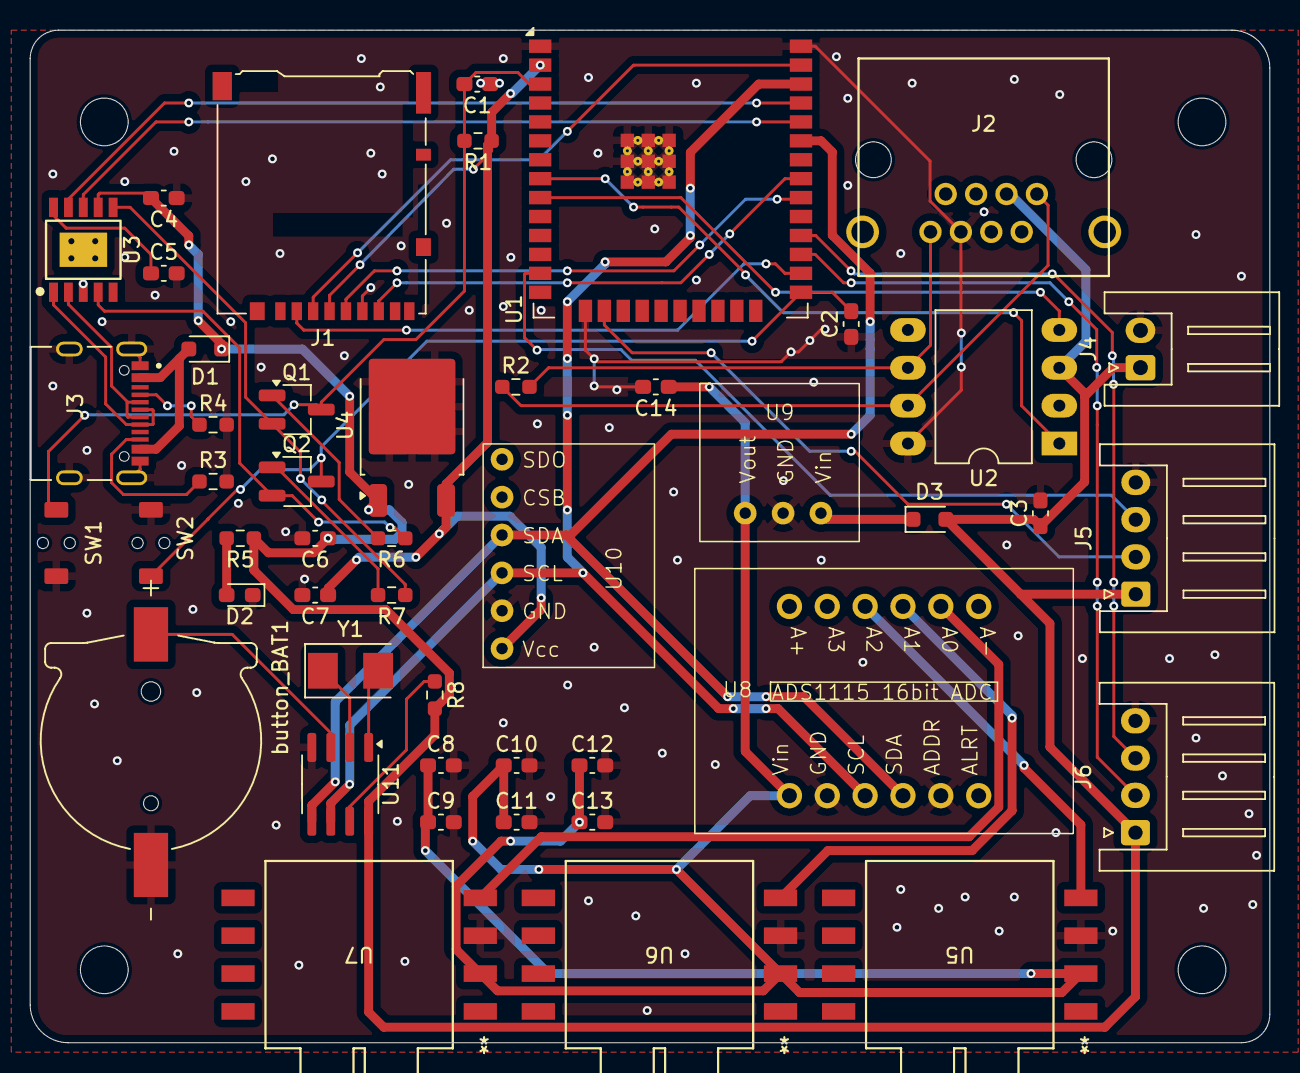
[picture p22: board AirDataCenter.kicad_pcb from above]

Board: 2 copper layers, 83.2 x 67.9 mm, 48 parts (0 on the bottom side), 41 nets.
