Tail-BackShape/RTR24Lien-AvioSys/(commit log)

2024-06-23 add BMX055-sample
2024-06-23 add Main-IMU-test1
2024-06-23 add AirDataCenter
    [AirDataCenter.kicad_pcb, AirDataCenter.kicad_sch, MCU.kicad_sch, Power.kicad_sch, bom.csv, designators.csv, positions.csv, sensor.kicad_sch]
2024-06-23 add ElvRdr-Angle
    [ElvRdr-Angle.kicad_pcb, ElvRdr-Angle.kicad_sch]
2024-06-23 add Main-IMU
    [MCU.kicad_sch, Main-IMU.csv, Main-IMU.kicad_pcb, Main-IMU.kicad_sch, Power.kicad_sch, bacup.kicad_pcb, bom.csv, designators.csv]
2024-06-23 add Power
    [Power.kicad_pcb, Power.kicad_sch, bom.csv, designators.csv, positions.csv]
2024-06-23 add RJ45hub
    [RJ45hub.kicad_pcb, RJ45hub.kicad_sch, bom.csv, designators.csv, positions.csv]
2024-07-04 add new files
    [mainIMU.stp]
2024-07-07 fix Main-IMU-test3
2024-07-07 fix Main-IMU-test4.ino
    SEND_CAN function is fixed.
    [Main-IMU-test4.ino]
2024-07-10 add CAN_receiver
    it can decode the CAN message from the main board
